lzyglow/ECE445_lab_notebook/Zhuoyuan/led.png

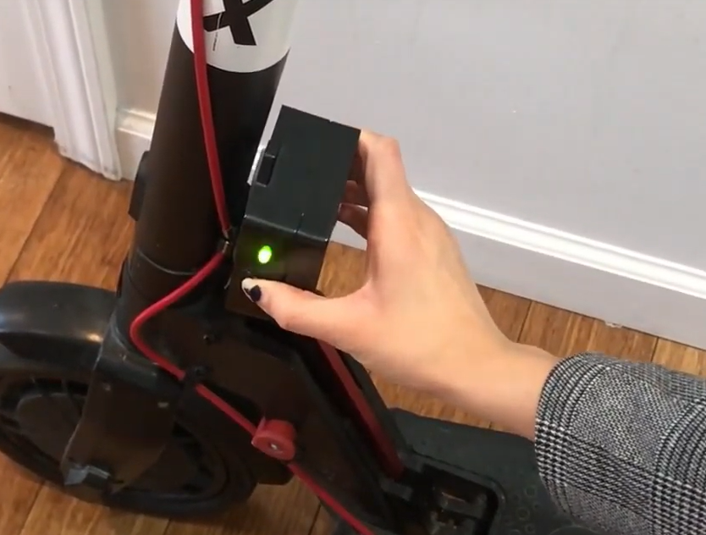
Zhuoyuan/led.png
